Cohesion3D/Cohesion3D-ReMix/(list of files, cad)

Other CAD files:
C3D ReMix rev2-bcream.dxf
C3D ReMix rev2-tcream.dxf
