Cohesion3D/Cohesion3D-ReMix/(threads)

Thread 1 (2017-09-03):

Folder and file names

JuculianD, 2017-09-03:
Hello.
I noticed that the BOMs and gerber files aren't named correctly.
Is it possible that you sort them correct?
Which BOM fits to the gerber files of CAM 4 and is the capacitor fault already corrected?

Thank you very much.

raykholo, 2017-09-03:
This was my working directory, here are the final design files here: https://www.dropbox.com/sh/sp9kfoxc4ihlqrw/AAApjO8Mn0raxKPxMYFKgFWWa?dl=0

Thread 2 (2018-02-12):

OpenPnP

mcmega, 2018-02-12:
Hello!
I make a openpnp machine.
Where can I see the sources of firmware for the board Cohesion3D-ReMix?
I'm interested in working with UART.
I developed feeders and they will be on the common bus. Data transfer will be carried out on the UART interface. It would be nice to have the ability to send custom commands to the UART.

raykholo, 2018-02-12:
It runs Smoothieware, they have a Github Repo.  Also Marlin 2.0 just got
C3D boards support, so this is another option.

You should investigate the switch module in Smoothie to see if this is
something you can use.

On Mon, Feb 12, 2018 at 12:33 PM, Oleg Perevyshin <notifications@github.com>
wrote:

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

--
Ray
