Cohesion3D/Cohesion3D-ReMix/C3D ReMix Expansion - Extruder Board/C3D ReMix Expansion - Extruder Board.brd

## EAGLE design C3D ReMix Expansion - Extruder Board/C3D ReMix Expansion - Extruder Board.brd (2016-07-06)

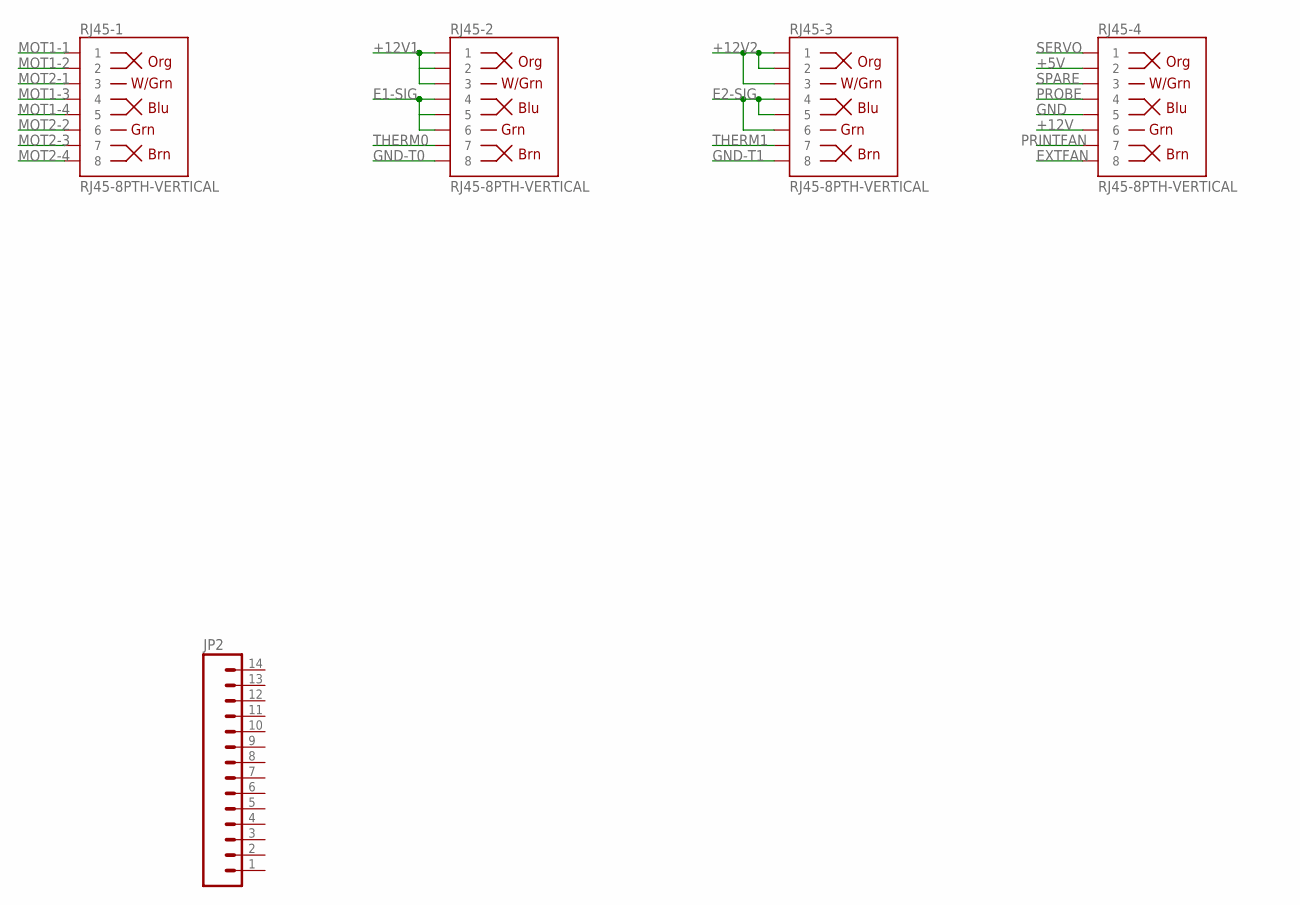
[picture p1: schematic C3D ReMix Expansion - Extruder Board.sch]

Parts:
JP2: M14; 1X14
RJ45-1, RJ45-2, RJ45-3, RJ45-4: RJ45-8PTH-VERTICAL; RJ45-8

Connections:
+5V: RJ45-4.2
+12V: RJ45-4.6
+12V1: RJ45-2.1, RJ45-2.2, RJ45-2.3
+12V2: RJ45-3.1, RJ45-3.2, RJ45-3.3
E1-SIG: RJ45-2.4, RJ45-2.5, RJ45-2.6
E2-SIG: RJ45-3.4, RJ45-3.5, RJ45-3.6
EXTFAN: RJ45-4.8
GND: RJ45-4.5
GND-T0: RJ45-2.8
GND-T1: RJ45-3.8
MOT1-1: RJ45-1.1
MOT1-2: RJ45-1.2
MOT1-3: RJ45-1.4
MOT1-4: RJ45-1.5
MOT2-1: RJ45-1.3
MOT2-2: RJ45-1.6
MOT2-3: RJ45-1.7
MOT2-4: RJ45-1.8
PRINTFAN: RJ45-4.7
PROBE: RJ45-4.4
SERVO: RJ45-4.1
SPARE: RJ45-4.3
THERM0: RJ45-2.7
THERM1: RJ45-3.7

Board: 2 copper layers, 5 parts (0 on the bottom side), 4 nets, no tracks yet.
