Cohesion3D/Cohesion3D-ReMix/C3D ReMix rev2.brd

## EAGLE design C3D ReMix rev2.brd (2016-07-06)

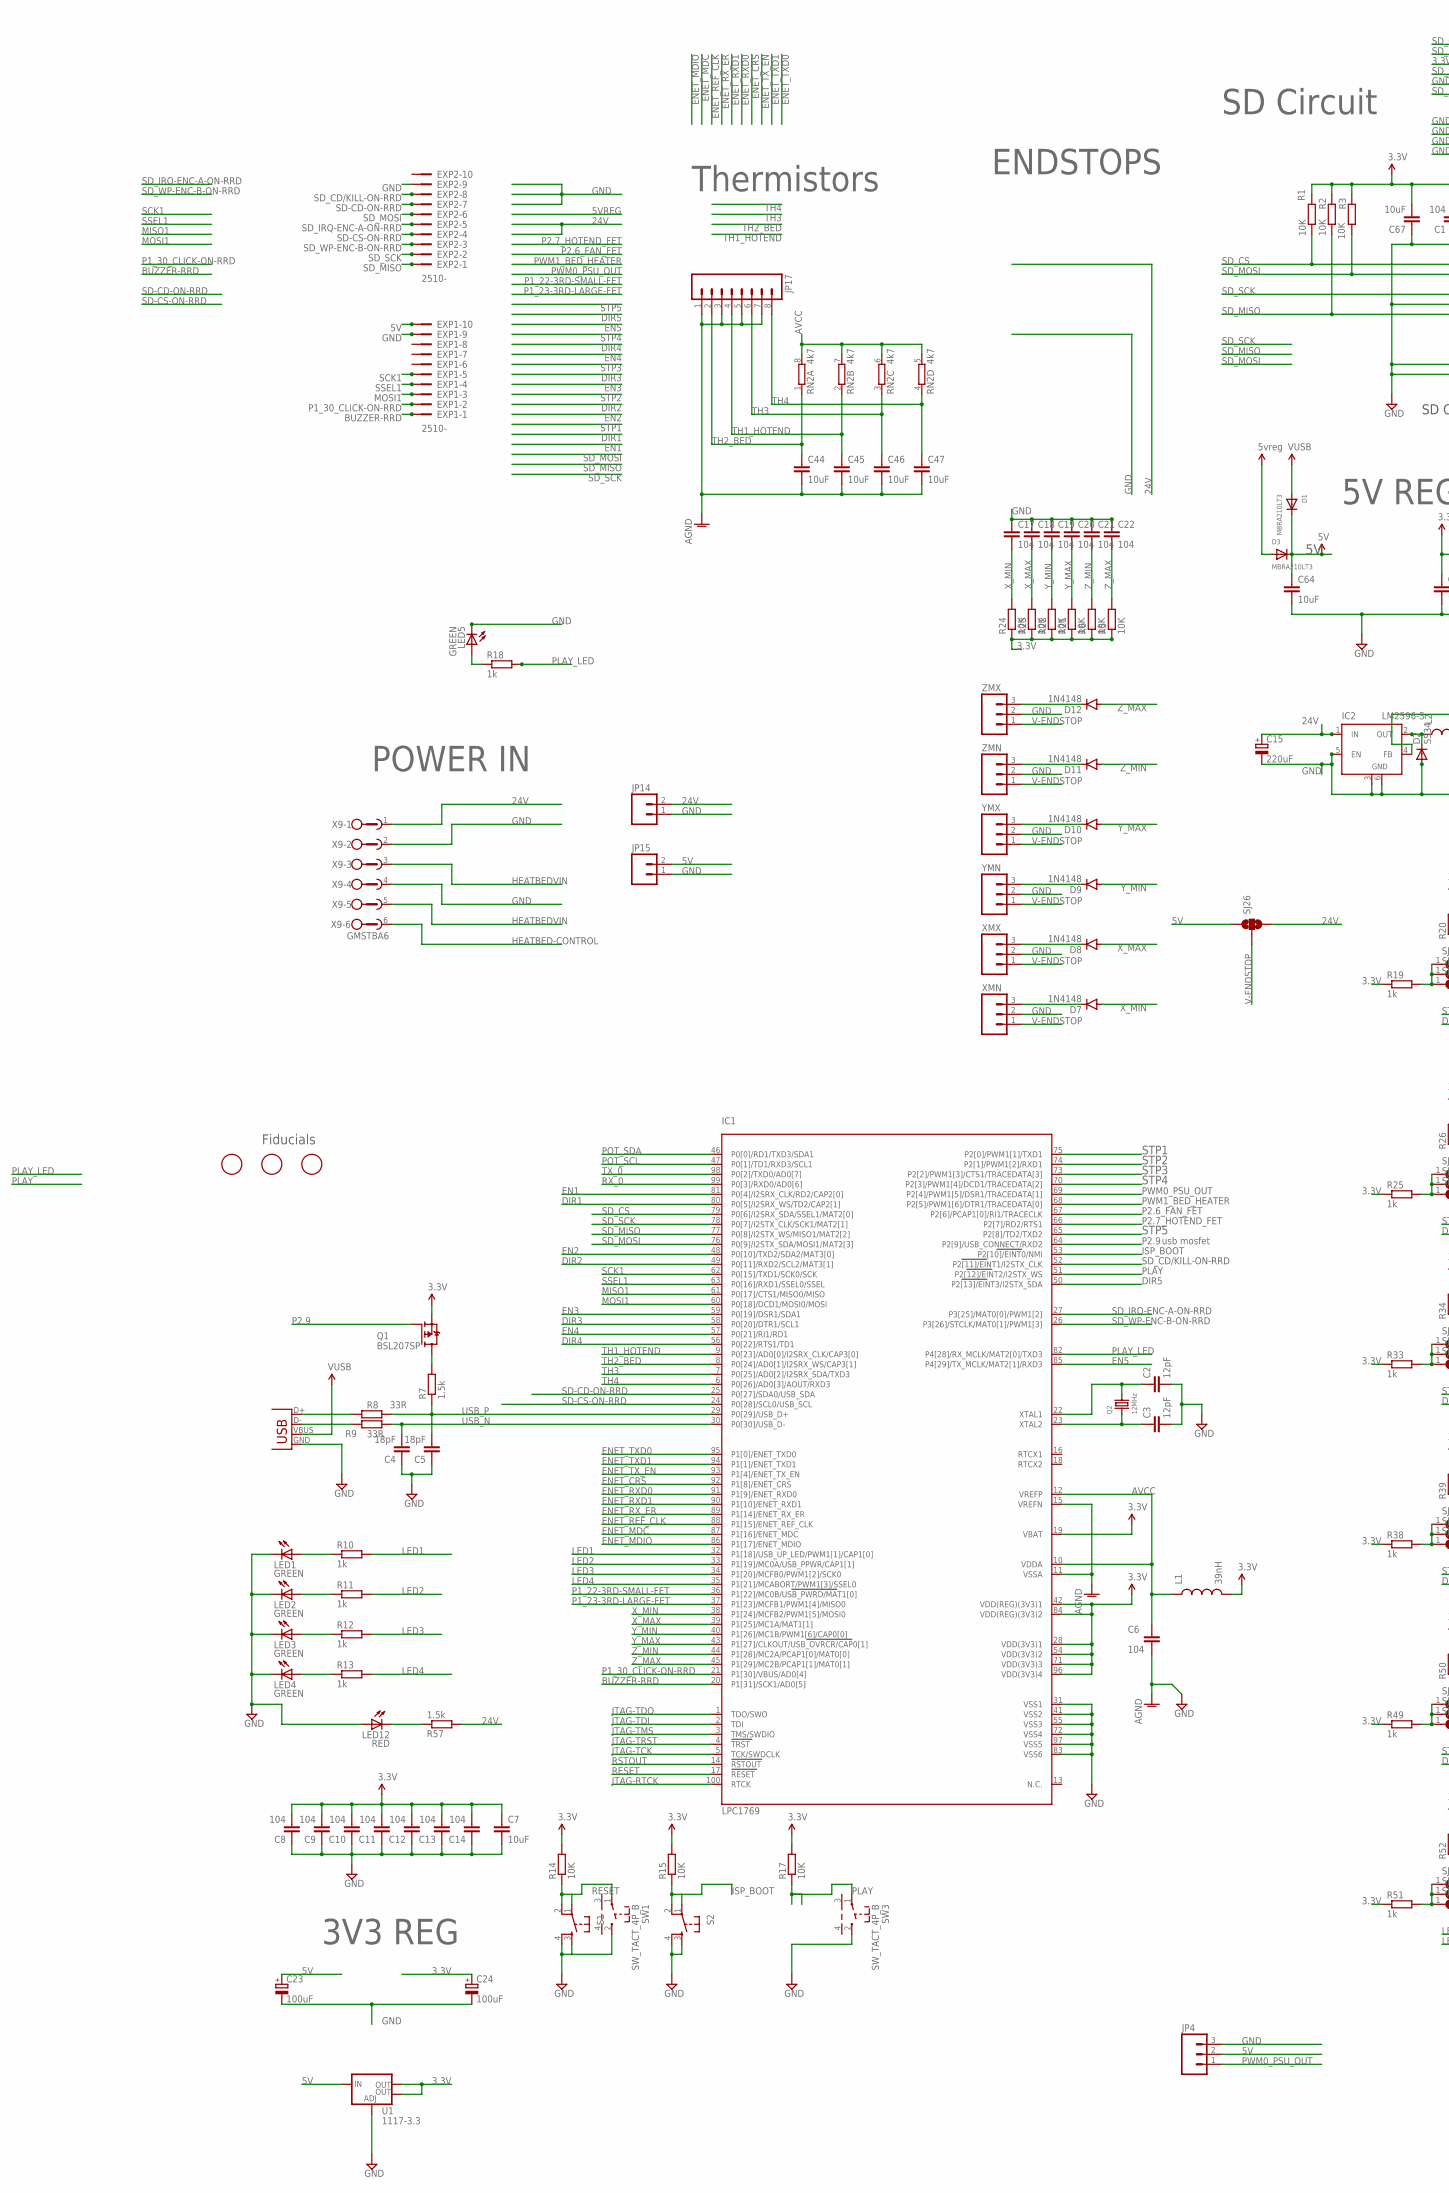
[picture p2: schematic C3D ReMix rev2.sch, part in row 1, column 1]

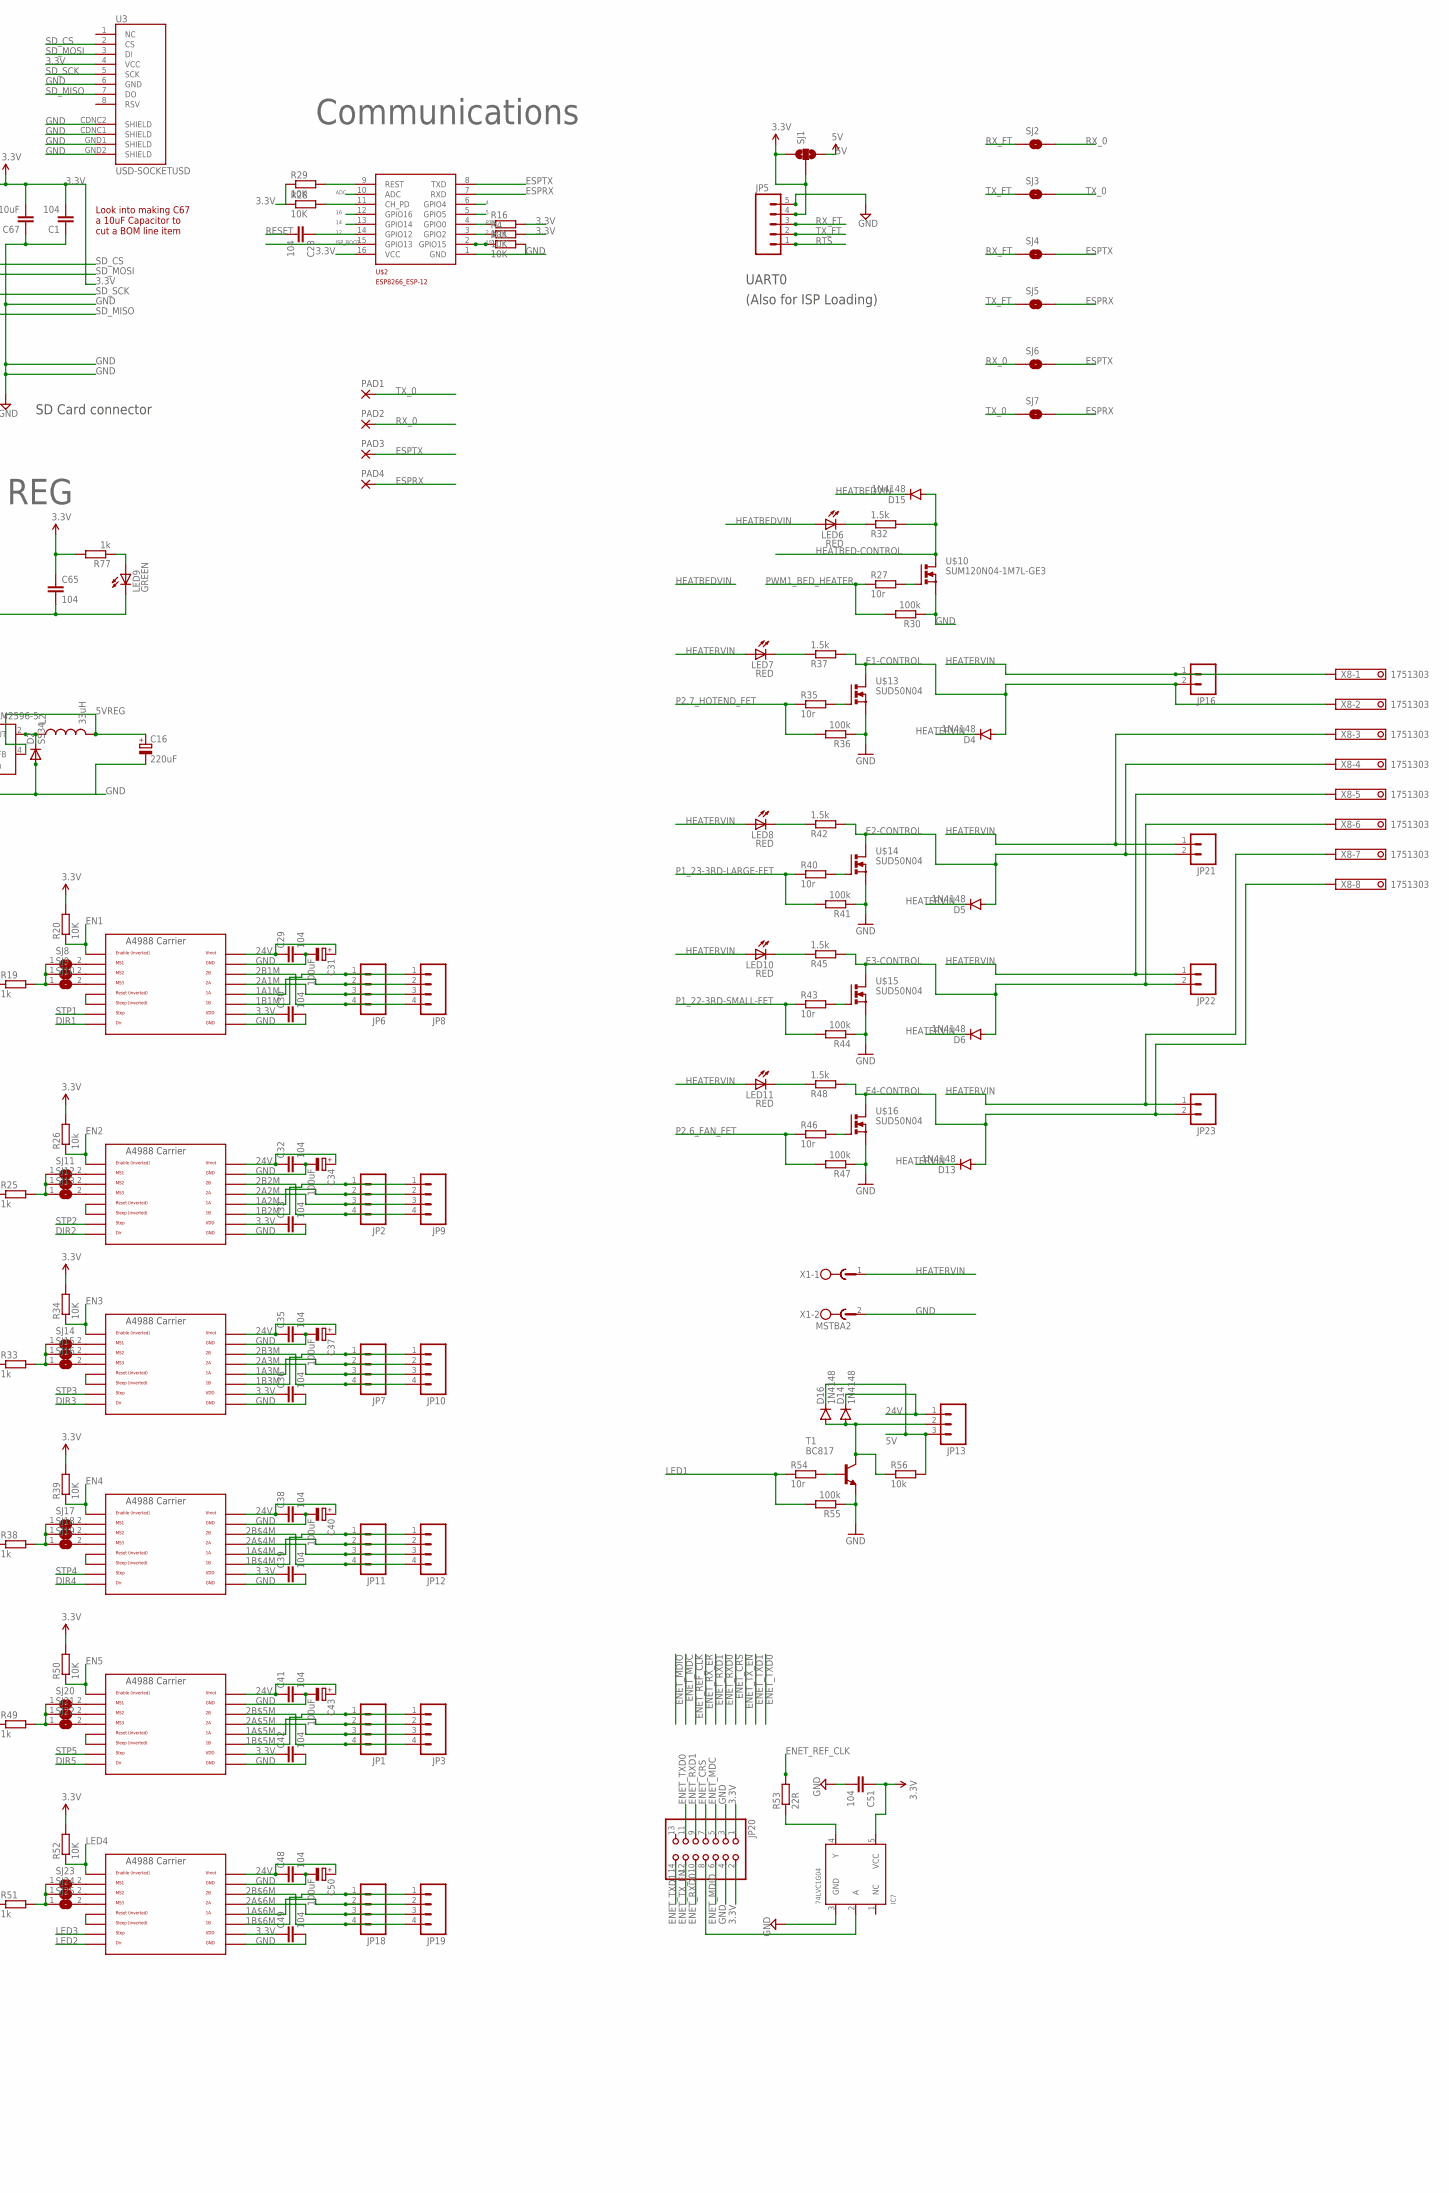
[picture p3: schematic C3D ReMix rev2.sch, part in row 1, column 2]

Parts:
C1, C6, C8, C9, C10, C11, C12, C13, C14, C17, C18, C19, C20, C21, C22, C28, C29, C30, C32, C33, C35, C36, C38, C39, C41, C42, C48, C49, C51, C65: 104; C0603
C2, C3: 12pF; C0603
C4, C5: 18pF; C0603
C7, C44, C45, C46, C47, C64, C67: 10uF; C0603
C15, C16: 220uF; 153CLV-0810
C23, C24, C31, C34, C37, C40, C43, C50: 100uF; 153CLV-0605
D1, D3: MBRA210LT3; SMADIODE
D2: SS34; DO-214AC
D4, D5, D6, D7, D8, D9, D10, D11, D12, D13, D14, D15, D16: 1N4148; SOD-323
EXP1, EXP2: 2510-; PAK100/2500-10
IC1: LPC1769; LQFP100
IC2: LM2596-5; TO263-5
IC7: 74LVC1G04; SOT23-5
JP1, JP2, JP6, JP7, JP11, JP18: M04POLAR_LOCK; MOLEX-1X4_LOCK
JP3, JP8, JP9, JP10, JP12, JP19: M04LOCK; 1X04_LOCK
JP4, JP13: M03LOCK; 1X03_LOCK
JP5: M05NO_SILK; 1X05_NO_SILK
JP14, JP15, JP16, JP21, JP22, JP23: M02LOCK; 1X02_LOCK
JP17: M08LOCK; 1X08_LOCK
JP20: PINHD-2X7; 2X07
L1: 39nH; 0603
L2: 33uH; CDRH125
LED1, LED2, LED3, LED4, LED5, LED9: GREEN; SML0603
LED6, LED7, LED8, LED10, LED11, LED12: RED; SML0603
PAD1, PAD2, PAD3, PAD4: 1,6/0,9
Q1: BSL207SP; SC74_INFINEON
Q2: 12MHz; CRYSTAL_3.2X2.5
R1, R2, R3, R4, R5, R6, R14, R15, R16, R17, R20, R21, R22, R23, R24, R28, R29, R31, R34, R39, R50, R52: 10K; R0603
R7, R32, R37, R42, R45, R48, R57: 1.5k; R0603
R8, R9: 33R; R0603
R10, R11, R12, R13, R18, R19, R25, R33, R38, R49, R51, R77: 1k; R0603
R26, R56: 10k; R0603
R27, R35, R40, R43, R46, R54: 10r; R0603
R30, R36, R41, R44, R47, R55: 100k; R0603
R53: 22R; R0603
RN2: 4k7; 0603-ARV
S1, S2: TAC_SWITCHSMD; TACTILE_SWITCH_SMD
SJ1, SJ26: SOLDERJUMPER_2WAYS; SJ_3
SJ2, SJ3, SJ4, SJ5, SJ6, SJ7: SOLDERJUMPERNC; SJ_2S
SJ8, SJ9, SJ10, SJ11, SJ12, SJ13, SJ14, SJ15, SJ16, SJ17, SJ18, SJ19, SJ20, SJ21, SJ22, SJ23, SJ24, SJ25: SJ
SW1, SW3: SW_TACT_4P_B; SW_TACT_STANDARD_RIGHT_ANGLE
T1: BC817; SOT23-BEC
U1: 1117-3.3; SOT223
U3: USD-SOCKETUSD; USD-SOCKET-PP
U$1, U$5, U$6, U$7, U$8, U$9: POLOLU_A4983CARRIER; A4988BREAKOUT
U$2: ESP8266_ESP-12; ESP8266-ESP12
U$10: SUM120N04-1M7L-GE3; D2PACK
U$11, U$12, U$17: FIDUCIAL; FIDUCIAL_1MM
U$13, U$14, U$15, U$16: SUD50N04; D-PAK_TO252AA
X1: MSTBA2
X8: 1751303
X9: GMSTBA6
X14: USBPTH; USB-B-PTH
XMN: M03POLAR_LOCK; MOLEX-1X3_LOCK
XMX: M03POLAR_LOCK; MOLEX-1X3_LOCK
YMN: M03POLAR_LOCK; MOLEX-1X3_LOCK
YMX: M03POLAR_LOCK; MOLEX-1X3_LOCK
ZMN: M03POLAR_LOCK; MOLEX-1X3_LOCK
ZMX: M03POLAR_LOCK; MOLEX-1X3_LOCK

Connections:
1A1M: JP6.2, JP8.2, U$1.1A
1A2M: JP2.2, JP9.2, U$5.1A
1A3M: JP7.2, JP10.2, U$6.1A
1A$4M: JP11.2, JP12.2, U$7.1A
1A$5M: JP1.2, JP3.2, U$8.1A
1A$6M: JP18.2, JP19.2, U$9.1A
1B1M: JP6.1, JP8.1, U$1.1B
1B2M: JP2.1, JP9.1, U$5.1B
1B3M: JP7.1, JP10.1, U$6.1B
1B$4M: JP11.1, JP12.1, U$7.1B
1B$5M: JP1.1, JP3.1, U$8.1B
1B$6M: JP18.1, JP19.1, U$9.1B
2: R4.1, U$2.3 (GPIO2)
2A1M: JP6.3, JP8.3, U$1.2A
2A2M: JP2.3, JP9.3, U$5.2A
2A3M: JP7.3, JP10.3, U$6.2A
2A$4M: JP11.3, JP12.3, U$7.2A
2A$5M: JP1.3, JP3.3, U$8.2A
2A$6M: JP18.3, JP19.3, U$9.2A
2B1M: JP6.4, JP8.4, U$1.2B
2B2M: JP2.4, JP9.4, U$5.2B
2B3M: JP7.4, JP10.4, U$6.2B
2B$4M: JP11.4, JP12.4, U$7.2B
2B$5M: JP1.4, JP3.4, U$8.2B
2B$6M: JP18.4, JP19.4, U$9.2B
3.3V: C1.2, C7.1, C8.2, C9.2, C10.2, C11.2, C12.2, C13.2, C14.2, C24.+, C30.1, C33.1, C36.1, C39.1, C42.1, C49.1, C51.1, C65.1, C67.2, IC1.19 (VBAT), IC1.28 (VDD(3V3)1), IC1.42 (VDD(REG)(3V3)1), IC1.54 (VDD(3V3)2), IC1.71 (VDD(3V3)3), IC1.84 (VDD(REG)(3V3)2), IC1.96 (VDD(3V3)4), IC7.5 (VCC), JP5.4, JP20.1, JP20.2, L1.2, Q1.4 (S), R1.2, R2.2, R3.2, R4.2, R5.1, R6.1, R14.2, R15.2, R16.2, R17.2, R19.1, R20.2, R21.1, R22.1, R23.1, R24.1, R25.1, R26.2, R28.1, R29.1, R33.1, R34.2, R38.1, R39.2, R49.1, R50.2, R51.1, R52.2, R77.2, SJ1.1, SJ1.2, U1.2 (OUT), U1.4 (OUT), U3.4 (VCC), U$1.VDD, U$2.16 (VCC), U$5.VDD, U$6.VDD, U$7.VDD, U$8.VDD, U$9.VDD
4: U$2.6 (GPIO4)
5: U$2.5 (GPIO5)
5V: C23.+, C64.1, D1.C, D3.C, D16.C, EXP1.10, JP4.2, JP13.3, JP15.2, R56.2, SJ1.3, SJ26.1, U1.3 (IN)
5VREG: C16.+, D3.A, IC2.4 (FB), L2.2
12: C28.1, U$2.14 (GPIO12)
14: U$2.13 (GPIO14)
15: R31.1, U$2.2 (GPIO15)
16: U$2.12 (GPIO16)
24V: C15.+, C29.1, C31.+, C32.1, C34.+, C35.1, C37.+, C38.1, C40.+, C41.1, C43.+, C48.1, C50.+, D14.C, IC2.1 (IN), JP13.1, JP14.2, R57.2, SJ26.3, U$1.VMOT, U$5.VMOT, U$6.VMOT, U$7.VMOT, U$8.VMOT, U$9.VMOT, X9.1
ADC: U$2.10 (ADC)
AGND: C6.2, C44.2, C45.2, C46.2, C47.2, IC1.11 (VSSA), IC1.15 (VREFN), JP17.1, JP17.3, JP17.5, JP17.7
AVCC: C6.1, IC1.10 (VDDA), IC1.12 (VREFP), L1.1, RN2.5 (2), RN2.6 (2), RN2.7 (2), RN2.8 (2)
BUZZER-RRD: EXP1.1, IC1.20 (P1[31]/SCK1/AD0[5])
DIR1: IC1.80 (P0[5]/I2SRX_WS/TD2/CAP2[1]), U$1.DIR
DIR2: IC1.49 (P0[11]/RXD2/SCL2/MAT3[1]), U$5.DIR
DIR3: IC1.58 (P0[20]/DTR1/SCL1), U$6.DIR
DIR4: IC1.56 (P0[22]/RTS1/TD1), U$7.DIR
DIR5: IC1.50 (P2[13]/EINT3/I2STX_SDA), U$8.DIR
E1-CONTROL: D4.A, JP16.2, R37.2, U$13.4 (D), X8.2
E2-CONTROL: D5.A, JP21.2, R42.2, U$14.4 (D), X8.4
E3-CONTROL: D6.A, JP22.2, R45.2, U$15.4 (D), X8.6
E4-CONTROL: D13.A, JP23.2, R48.2, U$16.4 (D), X8.8
EN1: IC1.81 (P0[4]/I2SRX_CLK/RD2/CAP2[0]), R20.1, U$1.EN
EN2: IC1.48 (P0[10]/TXD2/SDA2/MAT3[0]), R26.1, U$5.EN
EN3: IC1.59 (P0[19]/DSR1/SDA1), R34.1, U$6.EN
EN4: IC1.57 (P0[21]/RI1/RD1), R39.1, U$7.EN
EN5: IC1.85 (P4[29]/TX_MCLK/MAT2[1]/RXD3), R50.1, U$8.EN
ENET_CRS: IC1.92 (P1[8]/ENET_CRS), JP20.7
ENET_MDC: IC1.87 (P1[16]/ENET_MDC), JP20.5
ENET_MDIO: IC1.86 (P1[17]/ENET_MDIO), JP20.6
ENET_REF_CLK: IC1.88 (P1[15]/ENET_REF_CLK), R53.2
ENET_RXD0: IC1.91 (P1[9]/ENET_RXD0), JP20.10
ENET_RXD1: IC1.90 (P1[10]/ENET_RXD1), JP20.9
ENET_RX_ER: IC1.89 (P1[14]/ENET_RX_ER)
ENET_TXD0: IC1.95 (P1[0]/ENET_TXD0), JP20.11
ENET_TXD1: IC1.94 (P1[1]/ENET_TXD1), JP20.14
ENET_TX_EN: IC1.93 (P1[4]/ENET_TX_EN), JP20.12
ESPRX: PAD4.1, SJ5.2, SJ7.2, U$2.7 (RXD)
ESPTX: PAD3.1, SJ4.2, SJ6.2, U$2.8 (TXD)
GND: C1.1, C2.2, C3.2, C4.1, C5.1, C7.2, C8.1, C9.1, C10.1, C11.1, C12.1, C13.1, C14.1, C15.-, C16.-, C17.1, C18.1, C19.1, C20.1, C21.1, C22.1, C23.-, C24.-, C29.2, C30.2, C31.-, C32.2, C33.2, C34.-, C35.2, C36.2, C37.-, C38.2, C39.2, C40.-, C41.2, C42.2, C43.-, C48.2, C49.2, C50.-, C51.2, C64.2, C65.2, C67.1, D2.2 (A), EXP1.9, EXP2.9, IC1.31 (VSS1), IC1.41 (VSS2), IC1.55 (VSS3), IC1.72 (VSS4), IC1.83 (VSS6), IC1.97 (VSS5), IC2.3 (GND), IC2.5 (EN), IC2.6 (GND), IC7.3 (GND), JP4.3, JP5.5, JP14.1, JP15.1, JP20.3, JP20.4, LED1.C, LED2.C, LED3.C, LED4.C, LED5.C, LED9.C, LED12.A, R30.1, R31.2, R36.1, R41.1, R44.1, R47.1, R55.1, S1.3, S1.4, S2.3, S2.4, SW1.2, SW3.2, T1.E, U1.1 (ADJ), U3.6 (GND), U3.CDNC1 (SHIELD), U3.CDNC2 (SHIELD), U3.GND1 (SHIELD), U3.GND2 (SHIELD), U$1.GND, U$1.GND@0 (GND), U$2.1 (GND), U$5.GND, U$5.GND@0 (GND), U$6.GND, U$6.GND@0 (GND), U$7.GND, U$7.GND@0 (GND), U$8.GND, U$8.GND@0 (GND), U$9.GND, U$9.GND@0 (GND), U$10.3 (S), U$13.3 (S), U$14.3 (S), U$15.3 (S), U$16.3 (S), X1.2, X9.2, X9.4, X14.GND, XMN.2, XMX.2, YMN.2, YMX.2, ZMN.2, ZMX.2
HEATBED-CONTROL: D15.A, R32.2, U$10.2 (D), X9.6
HEATBEDVIN: D15.C, LED6.A, X9.3, X9.5
HEATERVIN: D4.C, D5.C, D6.C, D13.C, JP16.1, JP21.1, JP22.1, JP23.1, LED7.A, LED8.A, LED10.A, LED11.A, X1.1, X8.1, X8.3, X8.5, X8.7
ISP_BOOT: IC1.53 (P2[10]/EINT0/NMI), R15.1, S2.1, S2.2, U$2.15 (GPIO13)
JTAG-RTCK: IC1.100 (RTCK)
JTAG-TCK: IC1.5 (TCK/SWDCLK)
JTAG-TDI: IC1.2 (TDI)
JTAG-TDO: IC1.1 (TDO/SWO)
JTAG-TMS: IC1.3 (TMS/SWDIO)
JTAG-TRST: IC1.4 (TRST)
LED1: IC1.32 (P1[18]/USB_UP_LED/PWM1[1]/CAP1[0]), R10.2, R54.1, R55.2
LED2: IC1.33 (P1[19]/MC0A/USB_PPWR/CAP1[1]), R11.2, U$9.DIR
LED3: IC1.34 (P1[20]/MCFB0/PWM1[2]/SCK0), R12.2, U$9.STEP
LED4: IC1.35 (P1[21]/MCABORT/PWM1[3]/SSEL0), R13.2, R52.1, U$9.EN
MISO1: IC1.61 (P0[17]/CTS1/MISO0/MISO)
MOSI1: EXP1.3, IC1.60 (P0[18]/DCD1/MOSI0/MOSI)
unnamed: C2.1, IC1.22 (XTAL1), Q2.2
unnamed: C3.1, IC1.23 (XTAL2), Q2.1
unnamed: LED5.A, R18.1
unnamed: D11.C, ZMN.3
unnamed: D10.C, YMX.3
unnamed: SJ8.2, U$1.MS1
unnamed: D9.C, YMN.3
unnamed: SJ9.2, U$1.MS2
unnamed: D2.1 (C), IC2.2 (OUT), L2.1
unnamed: SJ10.2, U$1.MS3
unnamed: D8.C, XMX.3
unnamed: U$5.RST, U$5.SLP (SLEEP)
unnamed: D7.C, XMN.3
unnamed: R25.2, SJ11.1, SJ12.1, SJ13.1
unnamed: SJ11.2, U$5.MS1
unnamed: D12.C, ZMX.3
unnamed: SJ12.2, U$5.MS2
unnamed: R28.2, U$2.11 (CH_PD)
unnamed: SJ13.2, U$5.MS3
unnamed: R27.2, U$10.1 (G)
unnamed: LED6.C, R32.1
unnamed: U$6.RST, U$6.SLP (SLEEP)
unnamed: LED12.C, R57.1
unnamed: R33.2, SJ14.1, SJ15.1, SJ16.1
unnamed: SJ14.2, U$6.MS1
unnamed: SJ15.2, U$6.MS2
unnamed: SJ16.2, U$6.MS3
unnamed: R35.2, U$13.1 (G)
unnamed: R19.2, SJ8.1, SJ9.1, SJ10.1
unnamed: LED7.C, R37.1
unnamed: U$7.RST, U$7.SLP (SLEEP)
unnamed: R38.2, SJ17.1, SJ18.1, SJ19.1
unnamed: SJ17.2, U$7.MS1
unnamed: SJ18.2, U$7.MS2
unnamed: U$1.RST, U$1.SLP (SLEEP)
unnamed: SJ19.2, U$7.MS3
unnamed: R40.2, U$14.1 (G)
unnamed: LED8.C, R42.1
unnamed: R43.2, U$15.1 (G)
unnamed: LED10.C, R45.1
unnamed: R46.2, U$16.1 (G)
unnamed: LED11.C, R48.1
unnamed: U$8.RST, U$8.SLP (SLEEP)
unnamed: R49.2, SJ20.1, SJ21.1, SJ22.1
unnamed: SJ20.2, U$8.MS1
unnamed: SJ21.2, U$8.MS2
unnamed: SJ22.2, U$8.MS3
unnamed: U$9.RST, U$9.SLP (SLEEP)
unnamed: R51.2, SJ23.1, SJ24.1, SJ25.1
unnamed: SJ23.2, U$9.MS1
unnamed: Q1.1 (D), Q1.2 (D), Q1.5 (D), Q1.6 (D), R7.2
unnamed: SJ24.2, U$9.MS2
unnamed: SJ25.2, U$9.MS3
unnamed: R54.2, T1.B
unnamed: D14.A, D16.A, JP13.2, R56.1, T1.C
unnamed: R8.1, X14.D+
unnamed: R9.1, X14.D-
unnamed: IC7.2 (A), JP20.8
unnamed: IC7.4 (Y), R53.1
unnamed: LED9.A, R77.1
unnamed: LED4.A, R13.1
unnamed: LED3.A, R12.1
unnamed: LED2.A, R11.1
unnamed: LED1.A, R10.1
P1_22-3RD-SMALL-FET: IC1.36 (P1[22]/MC0B/USB_PWRD/MAT1[0]), R43.1, R44.2
P1_23-3RD-LARGE-FET: IC1.37 (P1[23]/MCFB1/PWM1[4]/MISO0), R40.1, R41.2
P1_30_CLICK-ON-RRD: EXP1.2, IC1.21 (P1[30]/VBUS/AD0[4])
P2.6_FAN_FET: IC1.67 (P2[6]/PCAP1[0]/RI1/TRACECLK), R46.1, R47.2
P2.7_HOTEND_FET: IC1.66 (P2[7]/RD2/RTS1), R35.1, R36.2
P2.9: IC1.64 (P2[9]/USB_CONNECT/RXD2), Q1.3 (G)
PLAY: IC1.51 (P2[12]/EINT2/I2STX_WS), R17.1, SW3.1
PLAY_LED: IC1.82 (P4[28]/RX_MCLK/MAT2[0]/TXD3), R18.2
POT_SCL: IC1.47 (P0[1]/TD1/RXD3/SCL1)
POT_SDA: IC1.46 (P0[0]/RD1/TXD3/SDA1)
PWM0_PSU_OUT: IC1.69 (P2[4]/PWM1[5]/DSR1/TRACEDATA[1]), JP4.1
PWM1_BED_HEATER: IC1.68 (P2[5]/PWM1[6]/DTR1/TRACEDATA[0]), R27.1, R30.2
RESET: C28.2, IC1.17 (RESET), R14.1, S1.1, S1.2, SW1.1
RESET1: R29.2, U$2.9 (REST)
RSTOUT: IC1.14 (RSTOUT)
RTS: JP5.1, R16.1, U$2.4 (GPIO0)
RX_0: IC1.99 (P0[3]/RXD0/AD0[6]), PAD2.1, SJ2.2, SJ6.1
RX_FT: JP5.3, SJ2.1, SJ4.1
SCK1: EXP1.5, IC1.62 (P0[15]/TXD1/SCK0/SCK)
SD-CD-ON-RRD: EXP2.7, IC1.25 (P0[27]/SDA0/USB_SDA)
SD-CS-ON-RRD: EXP2.4, IC1.24 (P0[28]/SCL0/USB_SCL)
SD_CD/KILL-ON-RRD: EXP2.8, IC1.52 (P2[11]/EINT1/I2STX_CLK)
SD_CS: IC1.79 (P0[6]/I2SRX_SDA/SSEL1/MAT2[0]), R1.1, U3.2 (CS)
SD_IRQ-ENC-A-ON-RRD: EXP2.5, IC1.27 (P3[25]/MAT0[0]/PWM1[2])
SD_MISO: EXP2.1, IC1.77 (P0[8]/I2STX_WS/MISO1/MAT2[2]), R2.1, U3.7 (DO)
SD_MOSI: EXP2.6, IC1.76 (P0[9]/I2STX_SDA/MOSI1/MAT2[3]), R3.1, U3.3 (DI)
SD_SCK: EXP2.2, IC1.78 (P0[7]/I2STX_CLK/SCK1/MAT2[1]), U3.5 (SCK)
SD_WP-ENC-B-ON-RRD: EXP2.3, IC1.26 (P3[26]/STCLK/MAT0[1]/PWM1[3])
SSEL1: EXP1.4, IC1.63 (P0[16]/RXD1/SSEL0/SSEL)
STP1: IC1.75 (P2[0]/PWM1[1]/TXD1), U$1.STEP
STP2: IC1.74 (P2[1]/PWM1[2]/RXD1), U$5.STEP
STP3: IC1.73 (P2[2]/PWM1[3]/CTS1/TRACEDATA[3]), U$6.STEP
STP4: IC1.70 (P2[3]/PWM1[4]/DCD1/TRACEDATA[2]), U$7.STEP
STP5: IC1.65 (P2[8]/TD2/TXD2), U$8.STEP
TH1_HOTEND: C45.1, IC1.9 (P0[23]/AD0[0]/I2SRX_CLK/CAP3[0]), JP17.4, RN2.2 (1)
TH2_BED: C44.1, IC1.8 (P0[24]/AD0[1]/I2SRX_WS/CAP3[1]), JP17.2, RN2.1
TH3: C46.1, IC1.7 (P0[25]/AD0[2]/I2SRX_SDA/TXD3), JP17.6, RN2.3 (1)
TH4: C47.1, IC1.6 (P0[26]/AD0[3]/AOUT/RXD3), JP17.8, RN2.4 (1)
TX_0: IC1.98 (P0[2]/TXD0/AD0[7]), PAD1.1, SJ3.2, SJ7.1
TX_FT: JP5.2, SJ3.1, SJ5.1
USB_N: C4.2, IC1.30 (P0[30]/USB_D-), R9.2
USB_P: C5.2, IC1.29 (P0[29]/USB_D+), R7.1, R8.2
V-ENDSTOP: SJ26.2, XMN.1, XMX.1, YMN.1, YMX.1, ZMN.1, ZMX.1
VUSB: D1.A, X14.VBUS
X_MAX: C18.2, D8.A, IC1.39 (P1[25]/MC1A/MAT1[1]), R23.2
X_MIN: C17.2, D7.A, IC1.38 (P1[24]/MCFB2/PWM1[5]/MOSI0), R24.2
Y_MAX: C20.2, D10.A, IC1.43 (P1[27]/CLKOUT/USB_OVRCR/CAP0[1]), R21.2
Y_MIN: C19.2, D9.A, IC1.40 (P1[26]/MC1B/PWM1[6]/CAP0[0]), R22.2
Z_MAX: C22.2, D12.A, IC1.45 (P1[29]/MC2B/PCAP1[1]/MAT0[1]), R5.2
Z_MIN: C21.2, D11.A, IC1.44 (P1[28]/MC2A/PCAP1[0]/MAT0[0]), R6.2

Notes on the sheet:
SD Card connector
UART0
(Also for ISP Loading)
usb mosfet
5V REG
SD Circuit
Communications
3V3 REG
ENDSTOPS
Look into making C67 a 10uF Capacitor to cut a BOM line item
Thermistors
Fiducials
POWER IN

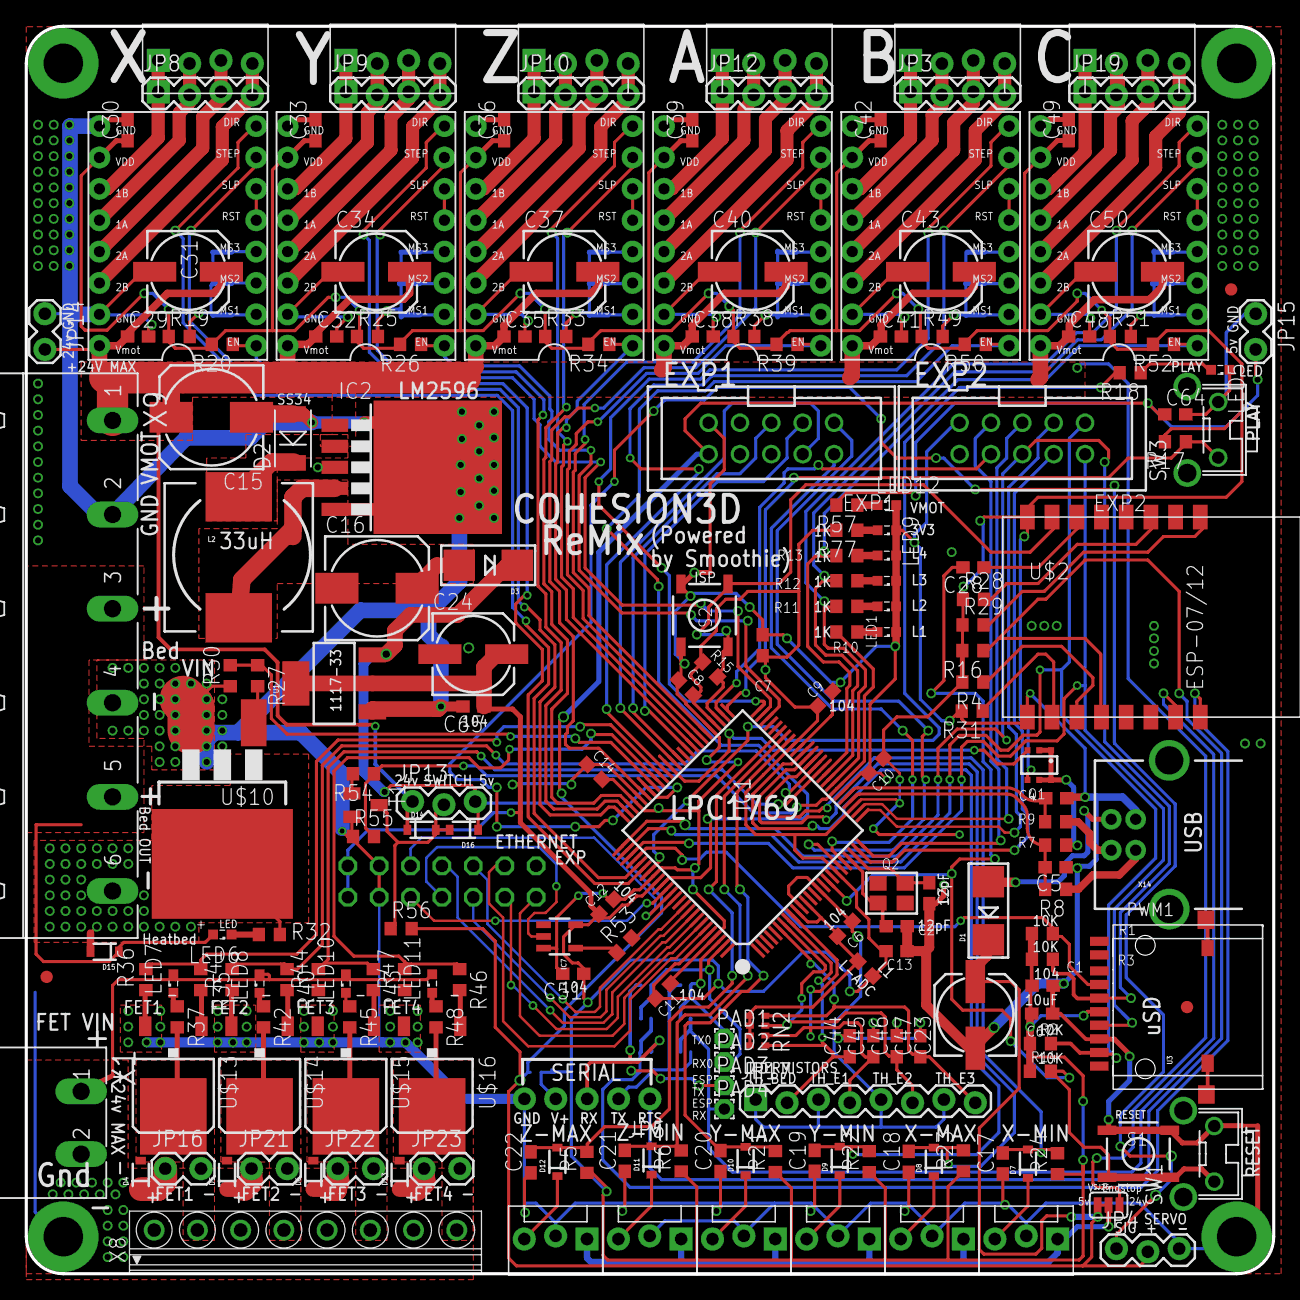
[picture p4: board C3D ReMix rev2.brd from above]

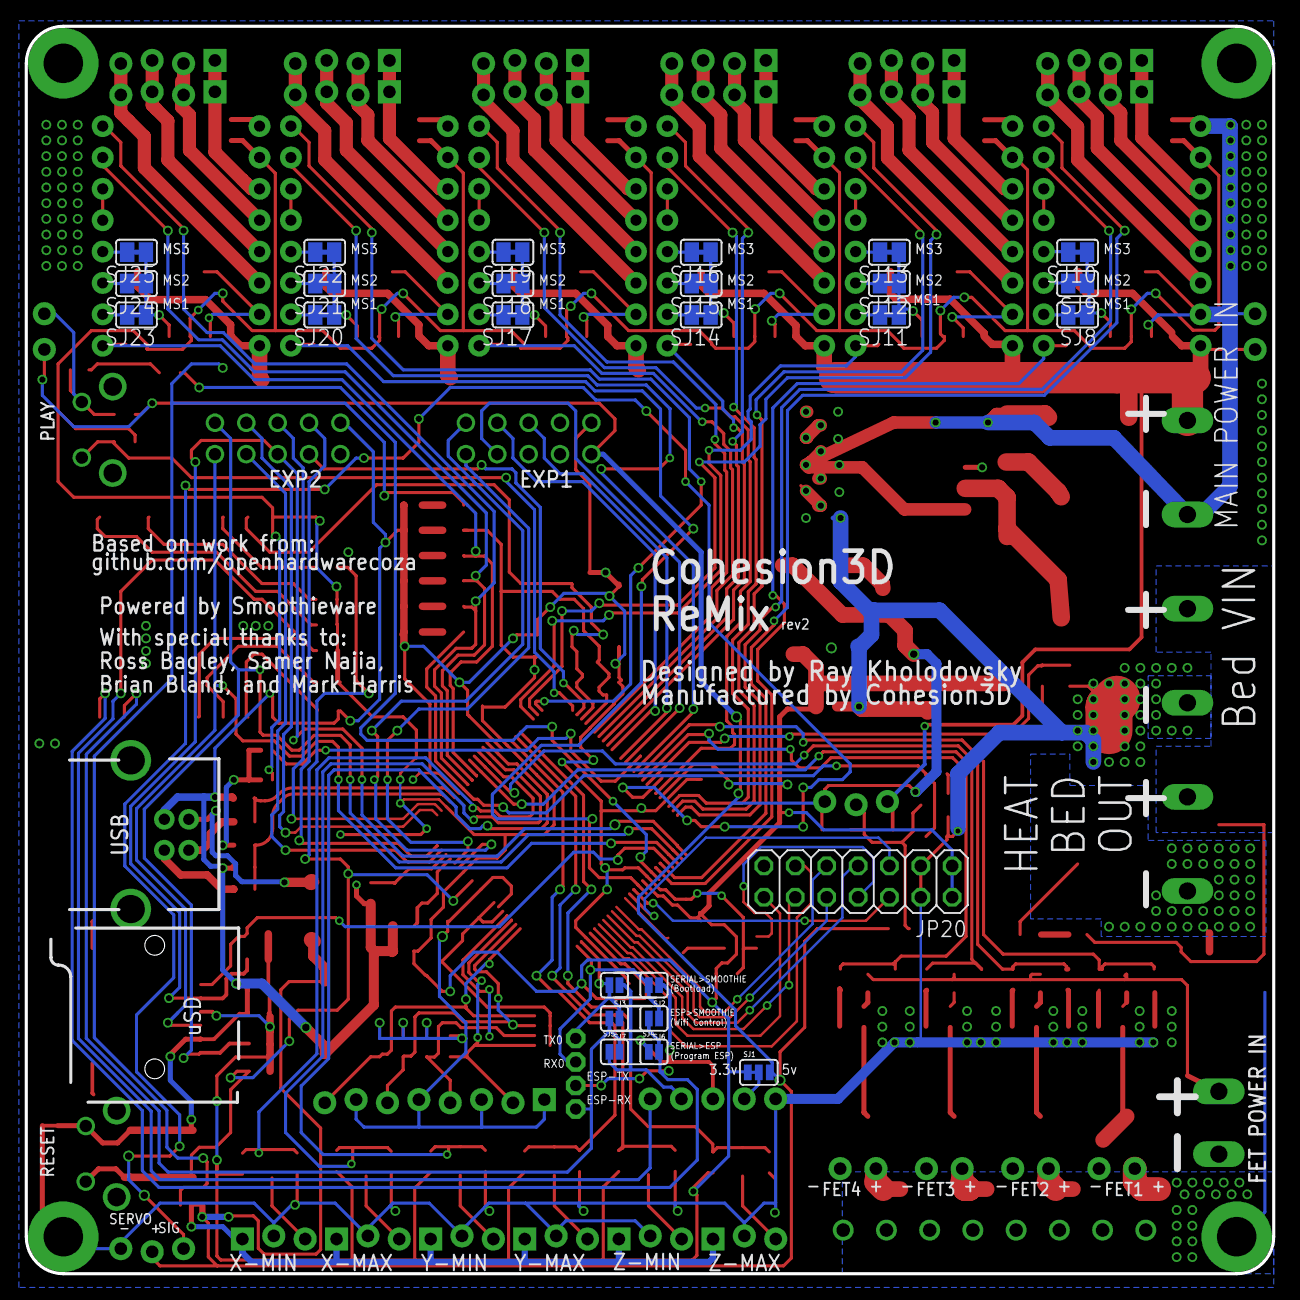
[picture p5: board C3D ReMix rev2.brd from below]

Board: 2 copper layers, 101.0 x 101.0 mm, 232 parts (26 on the bottom side), 180 nets.
