Cohesion3D/Cohesion3D-ReMix/C3D ReMix Expansion - RJ45 Hat/C3D ReMix Expansion - RJ45 Hat.brd

## EAGLE design C3D ReMix Expansion - RJ45 Hat/C3D ReMix Expansion - RJ45 Hat.brd (2016-07-06)

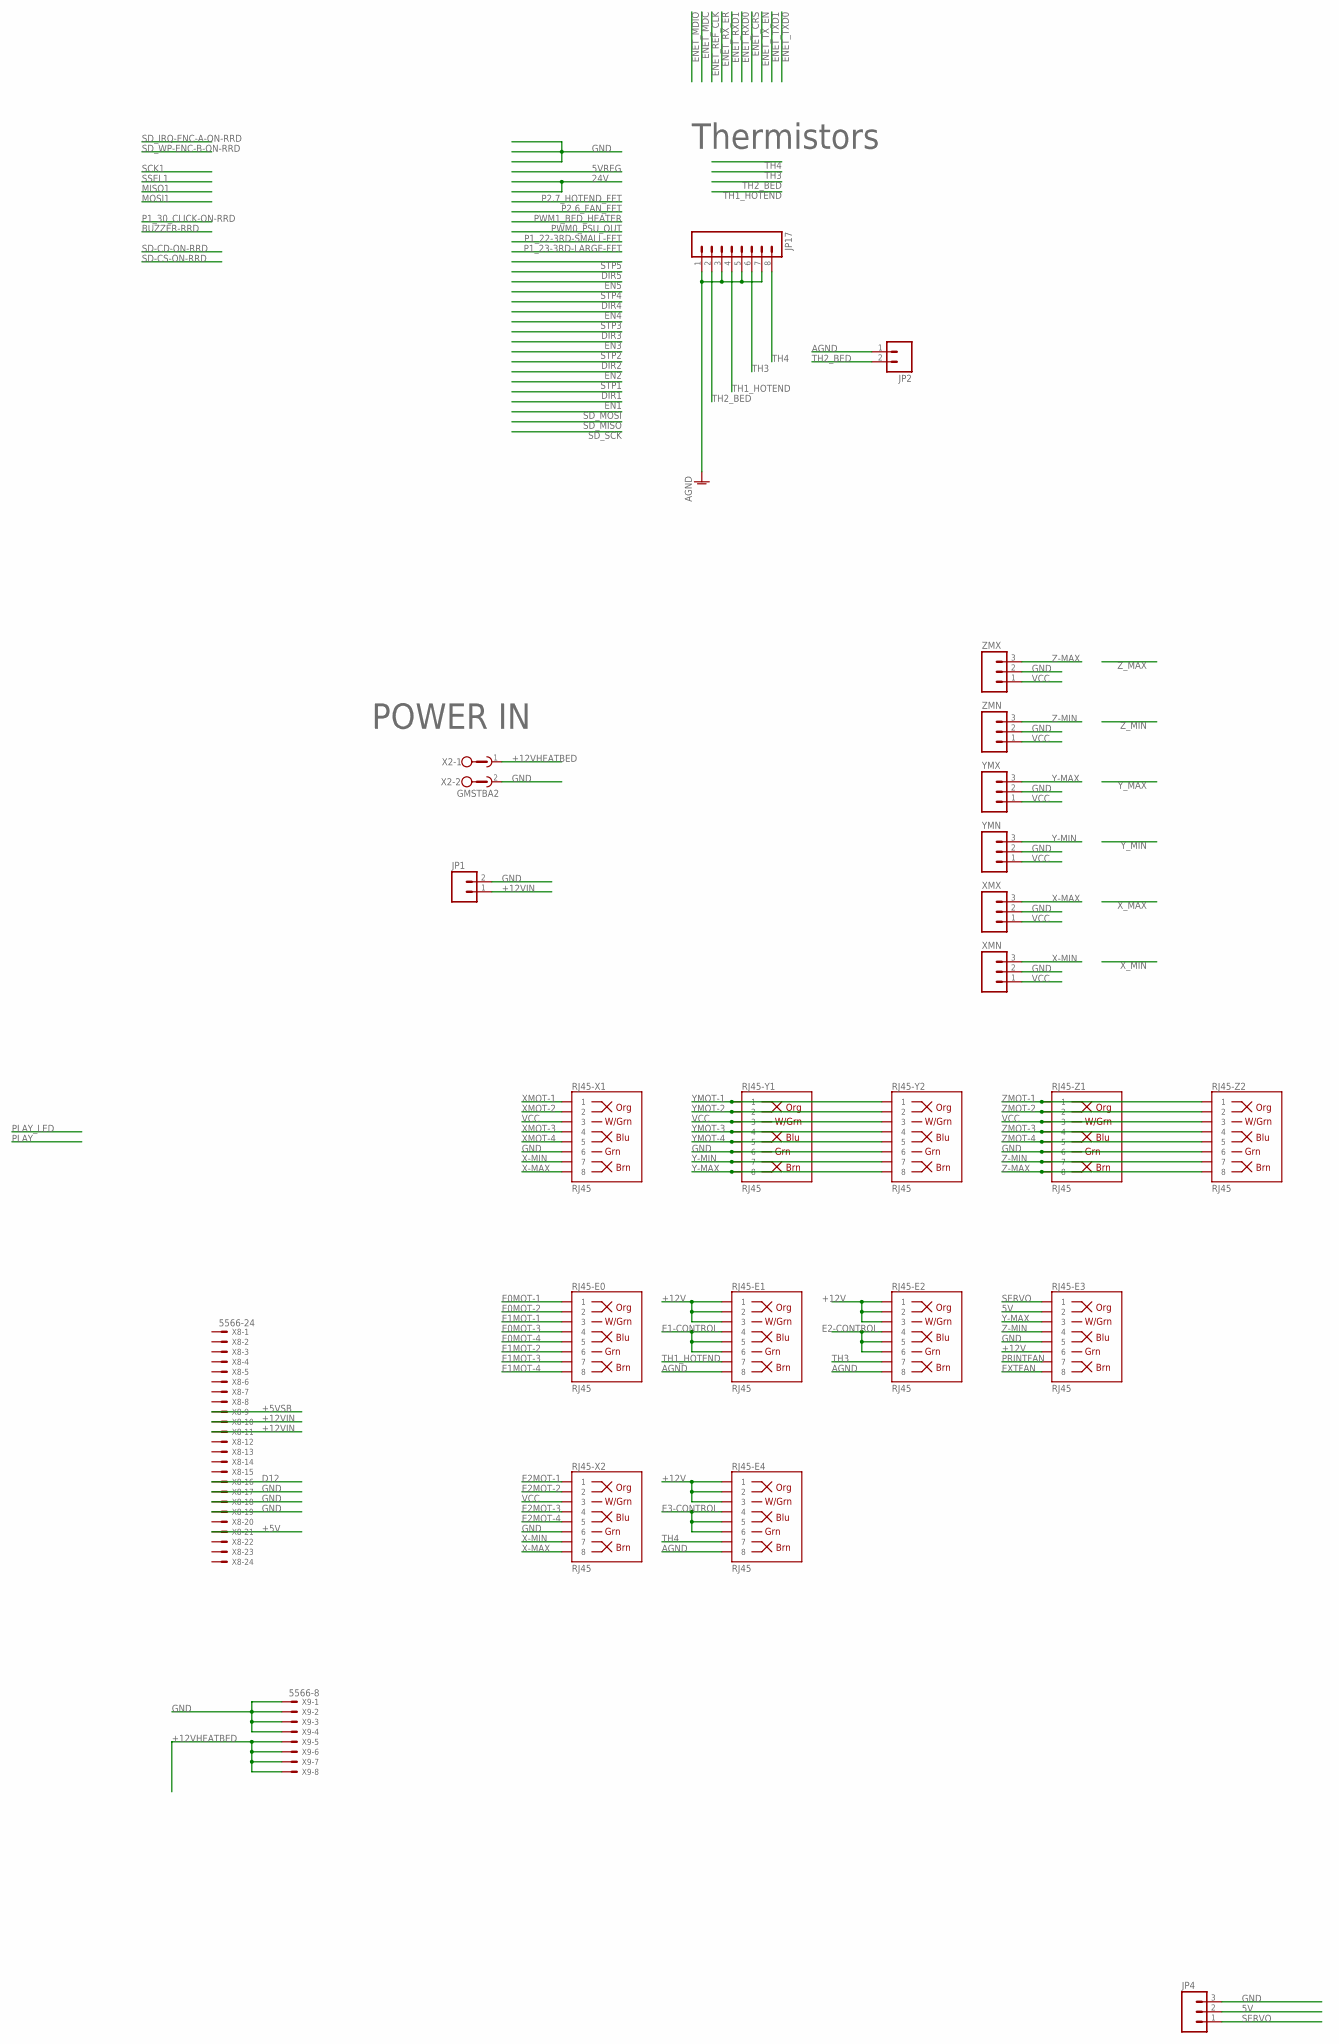
[picture p6: schematic C3D ReMix Expansion - RJ45 Hat.sch, part in row 1, column 1]

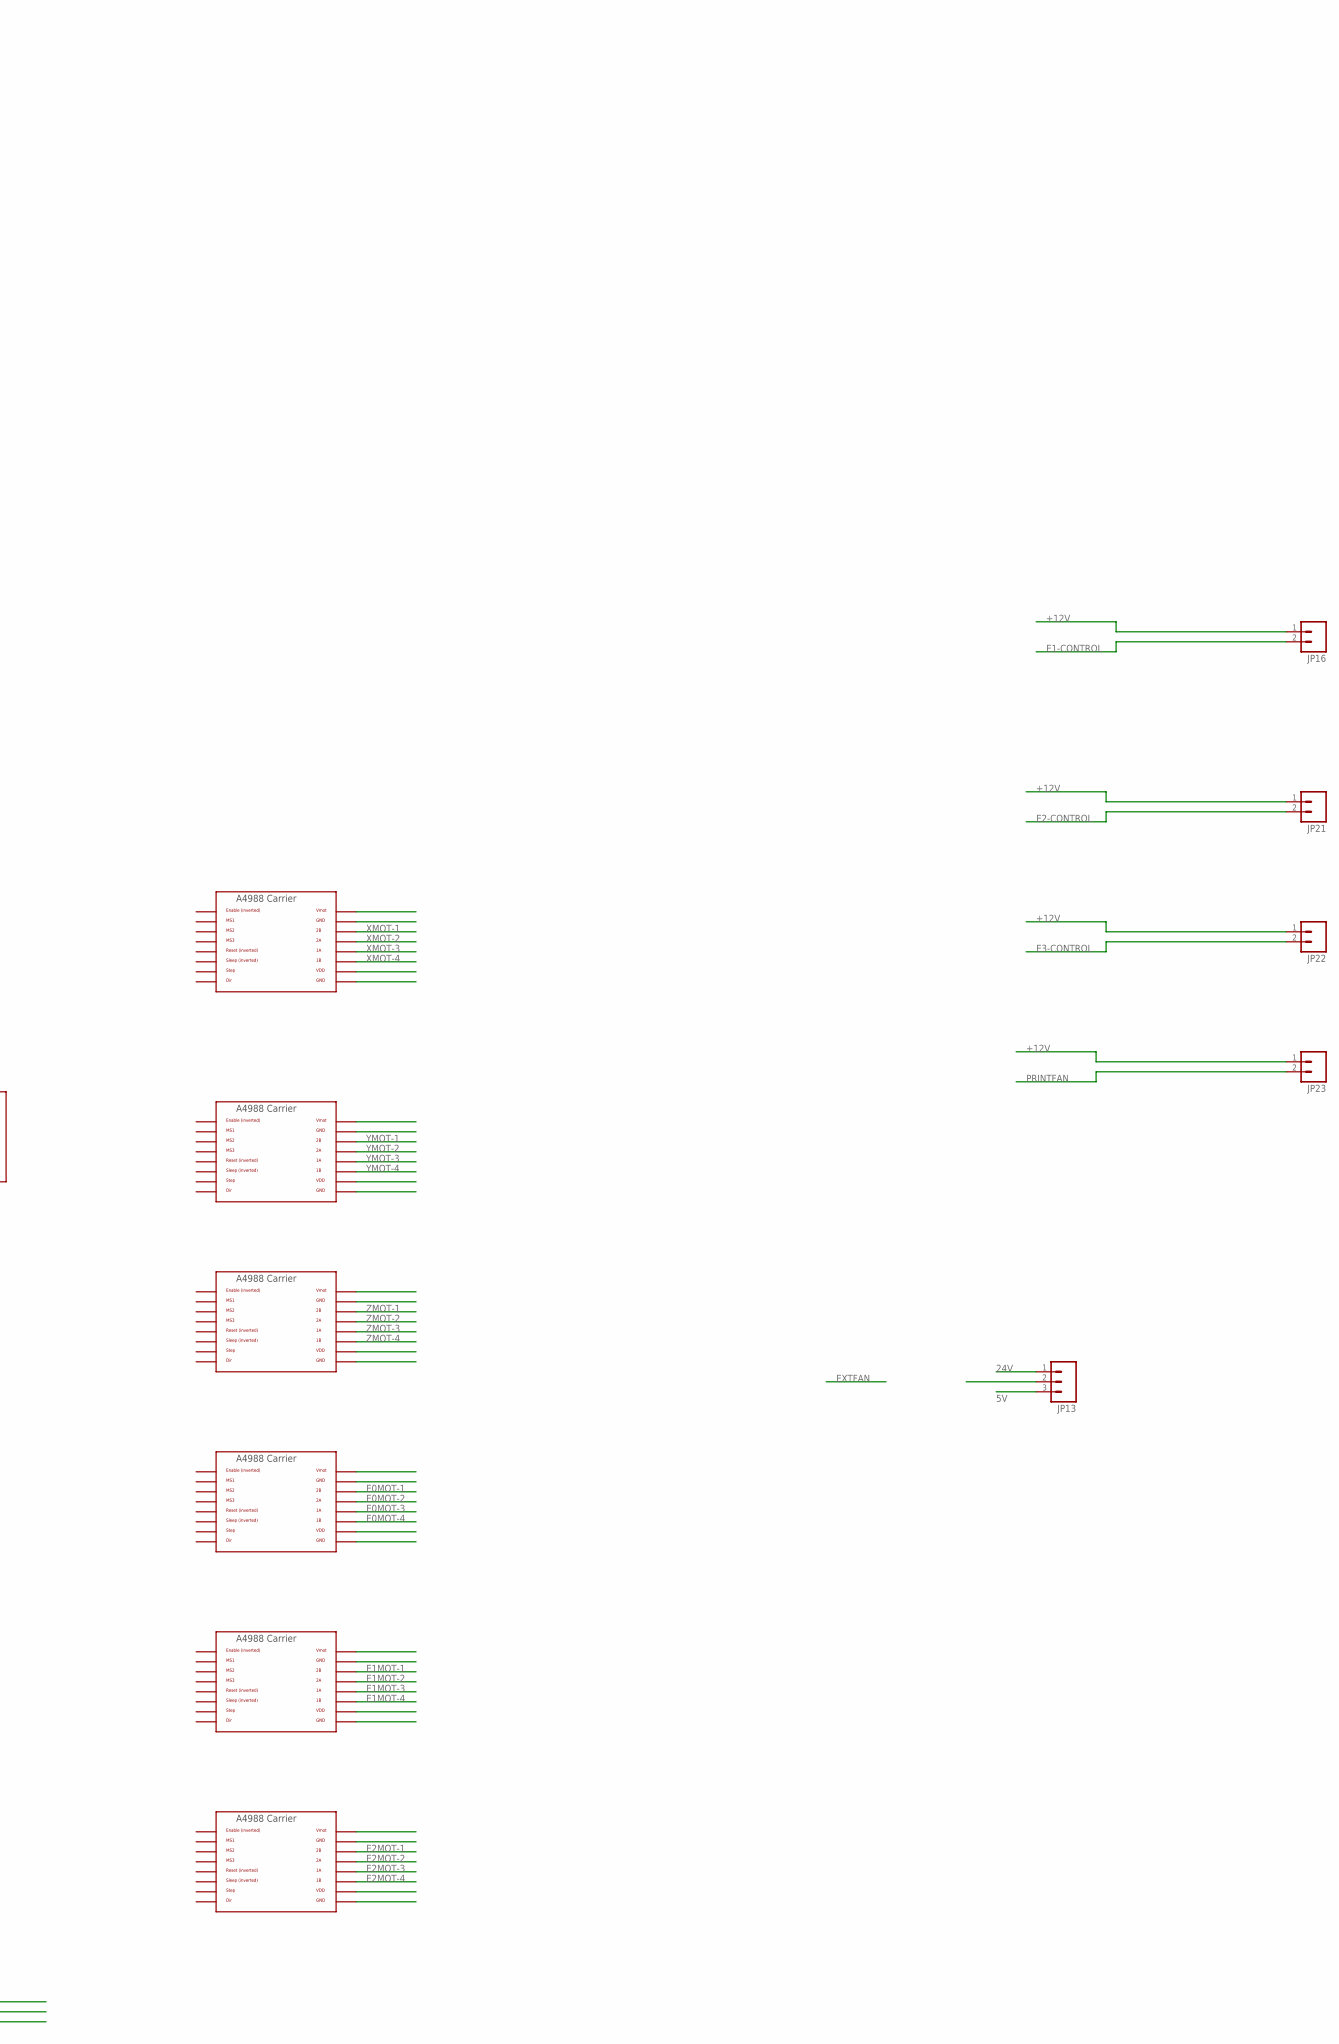
[picture p7: schematic C3D ReMix Expansion - RJ45 Hat.sch, part in row 1, column 2]

Parts:
JP1: M025MM; SCREWTERMINAL-5MM-2
JP2, JP16, JP21, JP22, JP23: M02LOCK; 1X02_LOCK
JP4: M03LOCK; 1X03_LOCK
JP13: M03LOCK_NO_SILK; 1X03_LOCK_NO_SILK
JP17: M08LOCK; 1X08_LOCK
RJ45-E0, RJ45-E1, RJ45-E2, RJ45-E3, RJ45-E4, RJ45-X1, RJ45-X2, RJ45-Y1, RJ45-Y2, RJ45-Z1, RJ45-Z2: RJ45; RJ45-8
U$1, U$5, U$6, U$7, U$8, U$9: POLOLU_A4983CARRIER; A4988BREAKOUT
X2: GMSTBA2
X8: 5566-24
X9: 5566-8
XMN: M03POLAR_LOCK; MOLEX-1X3_LOCK
XMX: M03POLAR_LOCK; MOLEX-1X3_LOCK
YMN: M03POLAR_LOCK; MOLEX-1X3_LOCK
YMX: M03POLAR_LOCK; MOLEX-1X3_LOCK
ZMN: M03POLAR_LOCK; MOLEX-1X3_LOCK
ZMX: M03POLAR_LOCK; MOLEX-1X3_LOCK

Connections:
5V: JP4.2, JP13.3, RJ45-E3.2
24V: JP13.1
+5V: X8.21
+5VSB: X8.9
+12V: JP16.1, JP21.1, JP22.1, JP23.1, RJ45-E1.1, RJ45-E1.2, RJ45-E1.3, RJ45-E2.1, RJ45-E2.2, RJ45-E2.3, RJ45-E3.6, RJ45-E4.1, RJ45-E4.2, RJ45-E4.3
+12VHEATBED: X2.1, X9.5, X9.6, X9.7, X9.8
+12VIN: JP1.1, X8.10, X8.11
AGND: JP2.1, JP17.1, JP17.3, JP17.5, JP17.7, RJ45-E1.8, RJ45-E2.8, RJ45-E4.8
D12: X8.16
E0MOT-1: RJ45-E0.1, U$7.2B
E0MOT-2: RJ45-E0.2, U$7.2A
E0MOT-3: RJ45-E0.4, U$7.1A
E0MOT-4: RJ45-E0.5, U$7.1B
E1-CONTROL: JP16.2, RJ45-E1.4, RJ45-E1.5, RJ45-E1.6
E1MOT-1: RJ45-E0.3, U$8.2B
E1MOT-2: RJ45-E0.6, U$8.2A
E1MOT-3: RJ45-E0.7, U$8.1A
E1MOT-4: RJ45-E0.8, U$8.1B
E2-CONTROL: JP21.2, RJ45-E2.4, RJ45-E2.5, RJ45-E2.6
E2MOT-1: RJ45-X2.1, U$9.2B
E2MOT-2: RJ45-X2.2, U$9.2A
E2MOT-3: RJ45-X2.4, U$9.1A
E2MOT-4: RJ45-X2.5, U$9.1B
E3-CONTROL: JP22.2, RJ45-E4.4, RJ45-E4.5, RJ45-E4.6
EXTFAN: RJ45-E3.8
GND: JP1.2, JP4.3, RJ45-E3.5, RJ45-X1.6, RJ45-X2.6, RJ45-Y1.6, RJ45-Y2.6, RJ45-Z1.6, RJ45-Z2.6, X2.2, X8.17, X8.18, X8.19, X9.1, X9.2, X9.3, X9.4, XMN.2, XMX.2, YMN.2, YMX.2, ZMN.2, ZMX.2
PRINTFAN: JP23.2, RJ45-E3.7
SERVO: JP4.1, RJ45-E3.1
TH1_HOTEND: JP17.4, RJ45-E1.7
TH2_BED: JP2.2, JP17.2
TH3: JP17.6, RJ45-E2.7
TH4: JP17.8, RJ45-E4.7
VCC: RJ45-X1.3, RJ45-X2.3, RJ45-Y1.3, RJ45-Y2.3, RJ45-Z1.3, RJ45-Z2.3, XMN.1, XMX.1, YMN.1, YMX.1, ZMN.1, ZMX.1
X-MAX: RJ45-X1.8, RJ45-X2.8, XMX.3
X-MIN: RJ45-X1.7, RJ45-X2.7, XMN.3
XMOT-1: RJ45-X1.1, U$1.2B
XMOT-2: RJ45-X1.2, U$1.2A
XMOT-3: RJ45-X1.4, U$1.1A
XMOT-4: RJ45-X1.5, U$1.1B
Y-MAX: RJ45-E3.3, RJ45-Y1.8, RJ45-Y2.8, YMX.3
Y-MIN: RJ45-Y1.7, RJ45-Y2.7, YMN.3
YMOT-1: RJ45-Y1.1, RJ45-Y2.1, U$5.2B
YMOT-2: RJ45-Y1.2, RJ45-Y2.2, U$5.2A
YMOT-3: RJ45-Y1.4, RJ45-Y2.4, U$5.1A
YMOT-4: RJ45-Y1.5, RJ45-Y2.5, U$5.1B
Z-MAX: RJ45-Z1.8, RJ45-Z2.8, ZMX.3
Z-MIN: RJ45-E3.4, RJ45-Z1.7, RJ45-Z2.7, ZMN.3
ZMOT-1: RJ45-Z1.1, RJ45-Z2.1, U$6.2B
ZMOT-2: RJ45-Z1.2, RJ45-Z2.2, U$6.2A
ZMOT-3: RJ45-Z1.4, RJ45-Z2.4, U$6.1A
ZMOT-4: RJ45-Z1.5, RJ45-Z2.5, U$6.1B

Notes on the sheet:
Thermistors
POWER IN

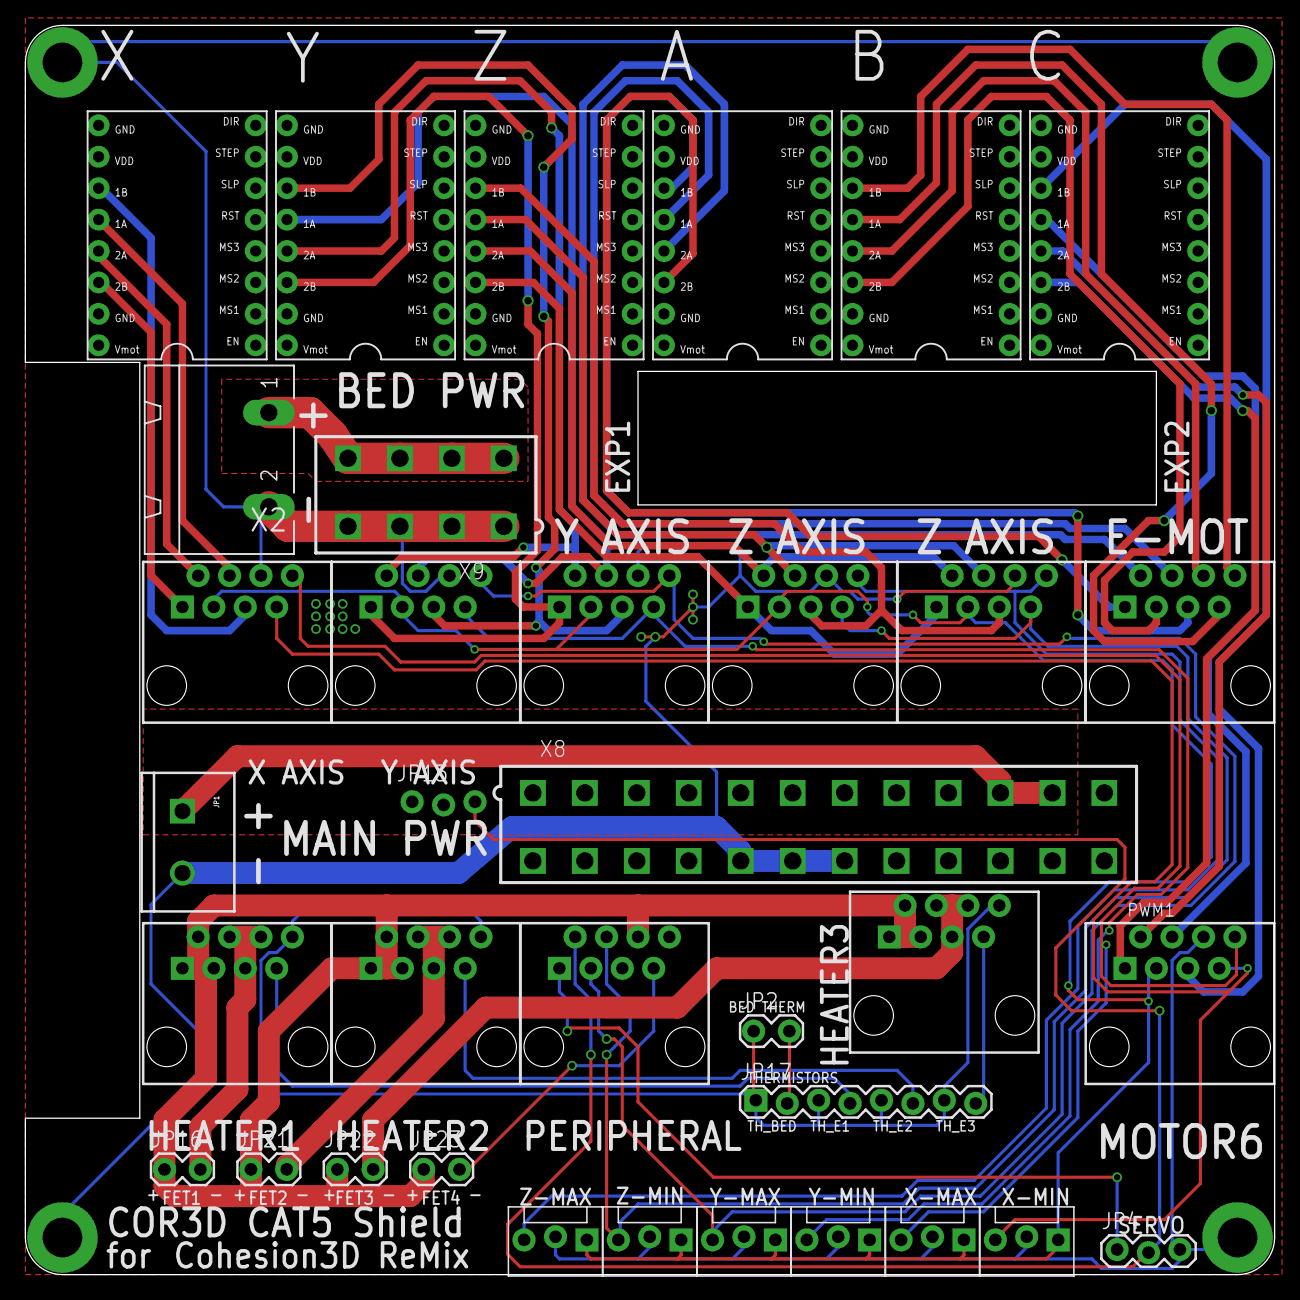
[picture p8: board C3D ReMix Expansion - RJ45 Hat.brd from above]

Board: 2 copper layers, 101.0 x 101.0 mm, 35 parts (0 on the bottom side), 46 nets.
