Cohesion3D/Cohesion3D-ReMix/(commit log)

2016-05-31 Initial Commit of v0 board designs
    [SmoothieBrainz - next round.brd, SmoothieBrainz - next round.sch]
2016-05-31 More cleanup. Changed 100u PTH to SMD
    [SmoothieBrainz - next round.brd]
2016-05-31 Moved some MOSFET copper pours around
    [SmoothieBrainz - next round.brd]
2016-05-31 Added VMOT indicator led
    [SmoothieBrainz - next round.brd, SmoothieBrainz - next round.sch]
2016-06-01 More Cleanup. Added Headers to Mosfet outputs
    [SmoothieBrainz - next round.brd, SmoothieBrainz - next round.sch]
2016-06-02 rev2 initial ready
    [SmoothieBrainz - next round.brd, SmoothieBrainz - next round.sch]
2016-06-02 CAM-0 generated. Peer review time.
    [SmoothieBrainz - next round.GBL, SmoothieBrainz - next round.GBO, SmoothieBrainz - next round.GBP, SmoothieBrainz - next round.GBS, SmoothieBrainz - next round.GTL, SmoothieBrainz - next round.GTO, SmoothieBrainz - next round.GTP, SmoothieBrainz - next round.GTS]
2016-06-02 Major routing cleanup per feedback from real engineer
    [SmoothieBrainz - next round.GBL, SmoothieBrainz - next round.GBO, SmoothieBrainz - next round.GBP, SmoothieBrainz - next round.GBS, SmoothieBrainz - next round.GTL, SmoothieBrainz - next round.GTO, SmoothieBrainz - next round.GTP, SmoothieBrainz - next round.GTS]
2016-06-05 About to fix ethernet
    [SmoothieBrainz - next round-VALUE.csv, SmoothieBrainz - next round.brd, SmoothieBrainz - next round.sch, SmoothieBrainz - next round_SBA_BOM-0.csv, SmoothieBrainz - next round_SBA_BOM-1.csv, SmoothieBrainz - next round_SBA_BOM-2.csv, SmoothieBrainz - next round_SBA_BOM.csv]
2016-06-10 Almost done, but need to replace 220uF caps with SMD
    [C3D ReMix rev2 - BOM.csv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]
2016-06-10 1/2 Cap 220uF Converted
    [C3D ReMix rev2.brd, C3D ReMix rev2.sch]
2016-07-06 Rev2, Huge Amount of stuff added
    [C3D ReMix Expansion - Extruder Board.brd, C3D ReMix Expansion - Extruder Board.sch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]
